fazhehy/ConLock/1_Hardware/主板.pdf

# 电池测量

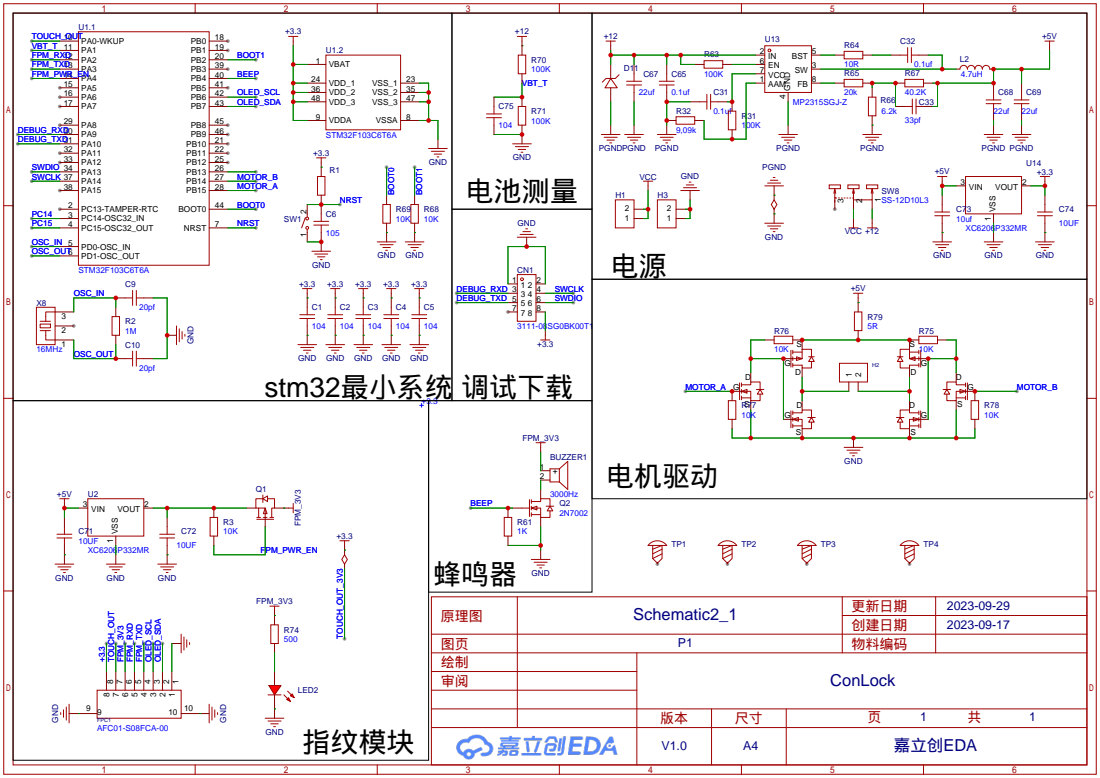
[picture p4: page 1]

GND GND
