fazhehy/ConLock/1_Hardware/副板.pdf

# FPM_3V3 TOUCH_OUT

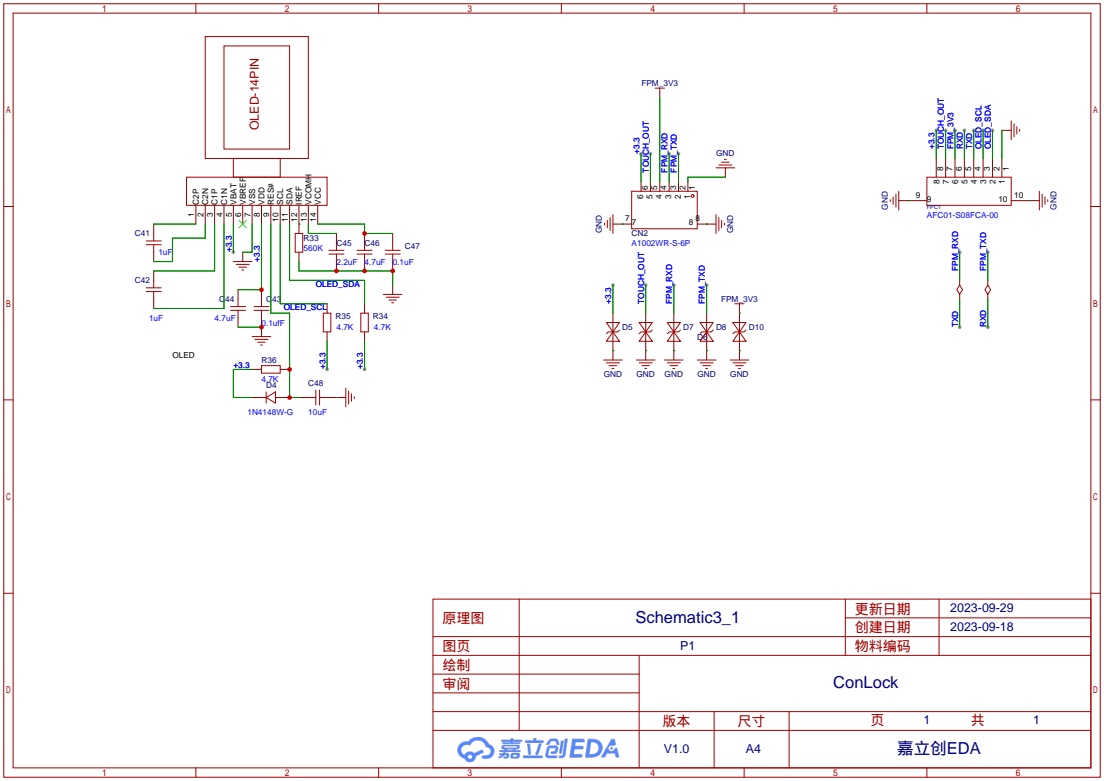
[picture p5: page 1]
