fazhehy/ConLock/2_Firmware/ConLock.ioc

Mcu.UserName=STM32F103C6Tx
PA0-WKUP.Signal=SYS_WKUP
PA1.Signal=ADCx_IN1
PA13.Signal=SYS_JTMS-SWDIO
PA14.Signal=SYS_JTCK-SWCLK
PA2.Signal=USART2_TX
PA3.Signal=USART2_RX
PA4.Signal=GPIO_Output
PB14.Signal=GPIO_Output
PB15.Signal=GPIO_Output
PB4.Signal=GPIO_Output
PB6.Signal=GPIO_Output
PB7.Signal=GPIO_Output
PD0-OSC_IN.Signal=RCC_OSC_IN
PD1-OSC_OUT.Signal=RCC_OSC_OUT
